dresner/paradiddlepadled/Paradiddlepadled.ioc

Mcu.UserName=STM32F411VETx
PA0-WKUP.GPIO_Label=GPIO_USER_BUTTON
PA0-WKUP.Signal=GPXTI0
PA2.Signal=USART2_TX
PA3.Signal=USART2_RX
PA4.Signal=I2S3_WS
PB10.Signal=SPI2_SCK
PB12.Signal=I2S3_CK
PB6.Signal=I2C1_SCL
PB7.Signal=S_TIM4_CH2
PB9.Signal=I2C1_SDA
PC12.Signal=I2S3_SD
PC2.Signal=SPI2_MISO
PC4.Signal=ADCx_IN14
PC7.Signal=I2S3_MCK
PD12.Signal=GPIO_Output
PD13.Signal=GPIO_Output
PD14.Signal=GPIO_Output
PD15.Signal=GPIO_Output
PD4.Signal=USART2_RTS
PE4.Signal=GPXTI4
