dresner/paradiddlepadled/Core/Inc/wav_data.h

uint16_t wav_data[] = {
   0x4952,0x4646,0x9e5a,0x0001,0x4157,0x4556,0x6d66,0x2074,
   0x0010,0x0000,0x0001,0x0002,0xac44,0x0000,0xb110,0x0002,
   0x0004,0x0010,0x6164,0x6174,0x9dc0,0x0001,0x0907,0x03be,
   0x0875,0x0441,0x07ef,0x04c1,0x0780,0x04de,0x0767,0x046a,
   0x074b,0x0394,0x06ac,0x0295,0x0583,0x015b,0x045c,0xffb1,
   0x0347,0xfdfd,0x01f0,0xfcc5,0x0066,0xfc33,0xff17,0xfbac,
   0xfe19,0xfad3,0xfd30,0xf9ba,0xfc57,0xf8ce,0xfba1,0xf808,
   0xfadd,0xf72d,0xfa18,0xf62b,0xf97c,0xf516,0xf8c7,0xf40e,
   0xf775,0xf2f1,0xf57a,0xf18f,0xf3c1,0xefb6,0xf2ae,0xed81,
   0xf214,0xeb55,0xf15b,0xe989,0xf086,0xe859,0xefb8,0xe7b1,
   0xef21,0xe763,0xeee7,0xe754,0xeee5,0xe7df,0xeef4,0xe922,
   0xef06,0xeab1,0xef7a,0xebbc,0xf07d,0xec09,0xf240,0xec30,
   0xf493,0xed0a,0xf727,0xee97,0xf960,0xf06d,0xfb1e,0xf20d,
   0xfc83,0xf361,0xfd9f,0xf485,0xfe54,0xf579,0xfe93,0xf66e,
   0xfe6c,0xf746,0xfe21,0xf7b6,0xfde3,0xf763,0xfde9,0xf66c,
   0xfdff,0xf542,0xfdc9,0xf453,0xfd09,0xf3cb,0xfc3e,0xf3b3,
   0xfbc3,0xf3fb,0xfb7a,0xf4e8,0xfb00,0xf62a,0xfa86,0xf749,
   0xfa2a,0xf7f6,0xfa18,0xf899,0xfa3f,0xf98f,0xfacb,0xfaf6,
   0xfb59,0xfcbc,0xfb9a,0xfea9,0xfb71,0x007f,0xfb69,0x01f9,
   0xfbae,0x033b,0xfc42,0x044b,0xfd05,0x052b,0xfdf3,0x0596,
   0xfebe,0x05a9,0xff27,0x0564,0xff51,0x04c4,0xffa5,0x03eb,
   0x001a,0x0322,0x005f,0x0274,0x0015,0x01f9,0xff10,0x01c5,
   0xfda9,0x01c3,0xfc4f,0x018a,0xfb7b,0x012a,0xfb4f,0x00f7,
   0xfbc1,0x0135,0xfc76,0x01a6,0xfd14,0x01fa,0xfd9d,0x01e9,
   0xfdfb,0x01b6,0xfe3b,0x01a7,0xfe4f,0x0207,0xfe53,0x0268,
   0xfeb9,0x0226,0xff82,0x00f9,0x0038,0xff82,0x00a0,0xfe61,
   0x00e1,0xfd5d,0x0147,0xfbf9,0x016d,0xfa2e,0x00fa,0xf8a0,
   0xfff3,0xf7c1,0xfe82,0xf76b,0xfcd7,0xf74f,0xfb52,0xf6ff,
   0xfa31,0xf645,0xf953,0xf55a,0xf866,0xf503,0xf786,0xf592,
   0xf6c8,0xf6bd,0xf66b,0xf7c4,0xf678,0xf885,0xf6e8,0xf985,
   0xf7b1,0xfb33,0xf8c0,0xfd87,0xf9db,0x0005,0xfac7,0x0238,
   0xfb70,0x0404,0xfc06,0x05af,0xfc90,0x0738,0xfcf5,0x087e,
   0xfd2c,0x094c,0xfd31,0x09ae,0xfd0c,0x09e7,0xfcb1,0x0a24,
   0xfc59,0x0a9e,0xfc2e,0x0b3d,0xfc24,0x0be5,0xfc09,0x0c30,
   0xfc1f,0x0c01,0xfc8c,0x0b91,0xfd01,0x0b22,0xfd14,0x0aa1,
   0xfcfc,0x09c9,0xfd3f,0x08bf,0xfde5,0x083e,0xfef2,0x087b,
   0x006f,0x08ed,0x0264,0x0947,0x0444,0x09c9,0x0579,0x0aa1,
   0x0606,0x0b77,0x0661,0x0bf0,0x06d4,0x0bfa,0x078b,0x0bc9,
   0x0897,0x0bc9,0x0985,0x0bf7,0x0a29,0x0bea,0x0ac4,0x0b4e,
   0x0ba8,0x0a70,0x0c71,0x09a5,0x0cb4,0x0918,0x0c51,0x08d6,
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
};
