dresner/paradiddlepadled/Core/Src/tester.cc

#include <tester.h>
#include <cstring>
#include "halal/led.h"
#include "halal/timer.h"
#include "tim.h"
#include "paradiddle.h"
#include "adc.h"

Serial_Console Tester::_console;

const Tester::Test Tester::_test_table[] = {
		{"hi",   "Show greeting", Tester::greet},
		{"help", "Show this help", Tester::help},
		{"ron",  "Turn on LED indicator of Right hit", Tester::right_on},
		{"roff", "Turn off LED indicator of Right hit", Tester::right_off},
		{"lon",  "Turn on LED indicator of Left hit", Tester::left_on},
		{"loff", "Turn off LED indicator of Left hit", Tester::left_off},
		{"mon",  "Start metronome", Tester::metronome_start},
		{"moff", "Stop metronome", Tester::metronome_stop},
		{"m+",   "Increase metronome BPM by 10", Tester::metronome_up},
		{"m-",   "Decrease metronome BPM by 10", Tester::metronome_down},
		{"m+1",  "Increase metronome BPM by 1", Tester::metronome_up_one},
		{"m-1",  "Decrease metronome BPM by 1", Tester::metronome_down_one},
		{"pn",   "Go to next paradiddle pattern", Paradiddle::next_pattern},
		{"pp",   "Go to previous paradiddle pattern", Paradiddle::previous_pattern},
		{"ads",  "ADC dump start", Tester::adc_dump_start},
		//{"pws",  "Play WAV sample", Tester::play_wav_sample},
		{"mg",   "Add more green to the LEDs", Tester::more_green},
		{"mr",   "Add more red to the LEDs", Tester::more_red},
};

LED_Strip *led_strip;

void Tester::metronome_start(void) {
	HAL_ADC_Start(&hadc1);
	Timer::start();
}
void Tester::metronome_stop(void) {
	Timer::stop();
	HAL_ADC_Stop(&hadc1);
}

Tester::Tester(void) {
	led_strip = LED_Strip::get_instance();
	led_strip->off<LED_Strip::Section::Left>();
	led_strip->off<LED_Strip::Section::Right>();
	greet();
}

void Tester::read_console(void) {
	std::string command;
	_console >> command;
	if (!run_test(command)) {
		_console << "Unrecognized command: " << command << _console.endl;
	}
}

void Tester::greet(void) {
	_console << "Hi! Welcome to Paradiddlepadled Tester v1.2dev" << _console.endl;
}

void Tester::help(void) {
	_console << "Available commands:" << _console.endl;
	for (const auto &t : _test_table) {
		_console << t.command << ": " << t.help << _console.endl;
	}
}

bool Tester::run_test(const std::string &command) {
	for (const auto &t : _test_table) {
		if (command == t.command) {
			t.callback();
			return true;
		}
	}
	return false;
}

void Tester::right_on(void) {
	led_strip->off<LED_Strip::Section::Left>();
	led_strip->on<LED_Strip::Section::Right>();
	LED{LED::Left{}}.off();
	LED{LED::Right{}}.on();
}
void Tester::right_off(void) {
	led_strip->off<LED_Strip::Section::Right>();
	LED{LED::Right{}}.off();
}
void Tester::left_on(void) {
	led_strip->off<LED_Strip::Section::Right>();
	led_strip->on<LED_Strip::Section::Left>();
	LED{LED::Right{}}.off();
	LED{LED::Left{}}.on();
}
void Tester::left_off(void) {
	led_strip->off<LED_Strip::Section::Left>();
	LED{LED::Left{}}.off();
}

void Tester::metronome_up(void) { Timer::bpm_up(10); }
void Tester::metronome_down(void) { Timer::bpm_down(10); }
void Tester::metronome_up_one(void) { Timer::bpm_up(1); }
void Tester::metronome_down_one(void) { Timer::bpm_down(1); }

void Tester::adc_dump_start(void) {
	HAL_ADC_Stop(&hadc1);
	while(true) {
		HAL_ADC_Start(&hadc1);
		HAL_ADC_PollForConversion(&hadc1, HAL_MAX_DELAY);
		uint32_t value = HAL_ADC_GetValue(&hadc1);
		HAL_ADC_Stop(&hadc1);
		_console << std::to_string(value) << _console.endl;
	}
}

//#include "wav_data.h"
#include <string.h>
#include "stm32f411e_discovery_audio.h"
typedef enum
{
  BUFFER_OFFSET_NONE = 0,
  BUFFER_OFFSET_HALF,
  BUFFER_OFFSET_FULL,
}BUFFER_StateTypeDef;

typedef struct
{
  uint32_t   ChunkID;       /* 0 */
  uint32_t   FileSize;      /* 4 */
  uint32_t   FileFormat;    /* 8 */
  uint32_t   SubChunk1ID;   /* 12 */
  uint32_t   SubChunk1Size; /* 16*/
  uint16_t   AudioFormat;   /* 20 */
  uint16_t   NbrChannels;   /* 22 */
  uint32_t   SampleRate;    /* 24 */

  uint32_t   ByteRate;      /* 28 */
  uint16_t   BlockAlign;    /* 32 */
  uint16_t   BitPerSample;  /* 34 */
  uint32_t   SubChunk2ID;   /* 36 */
  uint32_t   SubChunk2Size; /* 40 */

}WAVE_FormatTypeDef;
__IO BUFFER_StateTypeDef BufferOffset = BUFFER_OFFSET_NONE;
void BSP_AUDIO_OUT_HalfTransfer_CallBack(void) {
  BufferOffset = BUFFER_OFFSET_HALF;
}
void BSP_AUDIO_OUT_TransferComplete_CallBack(void) {
  BufferOffset = BUFFER_OFFSET_FULL;
}
void Tester::play_wav_sample(void) {
//	BufferOffset = BUFFER_OFFSET_NONE;
//	BSP_AUDIO_OUT_Init(OUTPUT_DEVICE_AUTO, 70, ((WAVE_FormatTypeDef*)wav_data)->SampleRate);
//	BSP_AUDIO_OUT_Play(wav_data, sizeof(wav_data));
//	while(BufferOffset != BUFFER_OFFSET_FULL);
//	BSP_AUDIO_OUT_Stop(CODEC_PDWN_HW);
}

void Tester::more_green(void) {
	led_strip->more_green();
}
void Tester::more_red(void) {
	led_strip->more_red();
}
