dresner/paradiddlepadled/(commit log)

2022-11-18 Start project with STM32CubeIDE defaults for STM32F411
2022-11-18 Add Serial_Console using UART2
2022-11-18 Add discoboard LEDs
2022-11-18 Add timer
2022-11-18 Adjust timer control
2022-11-18 Add LED pulses with PWM
2022-11-18 Add metronome LEDs
2022-11-18 Include stm32-ws2812b library
2022-11-18 LED strip working with metronome (naive)
2022-11-18 Time optimization writing to LED strip
2022-11-18 ADC apparently working
2022-11-18 Imported sample cs43l22 compiling
2022-11-18 Playing sample wav working (or almost...)
2022-11-18 Button control working
2022-11-18 Support changing LED strip colors
2022-11-18 Working hit detection by ADC interrupt
2022-11-18 Controlling LEDs according to hit accuracy
2022-11-18 Add state machine for handling button control
2022-11-18 Add button long hold to start/stop
2022-11-19 Changing some button inputs for accelerometer
2022-11-26 Improving ADC: decrease accuracy and change debouncing mechanism
